devtank-ltd/osm_env01_kicad/kicad_osm_env01/Design/osm_env-01_revC_pinmap_24_10_22.ods

 | RevB Pinmap |  | RevC Pinmap
STM Pin | CH Name | Connected to (KICAD LABEL) | NEW CH Name | NEW Connected to (KICAD LABEL) | Reason for change
PA0 | status_led | status_led | status_led | status_led
PA1 | ADC2 | CT+ | ADC2 | ADC2_OUT (CT1+) | Label update
PA2 | USART2_TX | RS232_RX | USART2_TX | DEBUG_RX | same function, new kicad label
PA3 | USART2_RX | RS232_TX | USART2_RX | DEBUG_TX | same function, new kicad label
PA4 | SPI1_CS | CS | ADC8 | ADC8_OUT (CT3+) | same function, new kicad label
PA5 | SPI1_SCK | STM_SCK | STM_SCK | STM_SCK
PA6 | SPI1_MISO | STM_MISO | STM_MISO | STM_MISO
PA7 | SPI1_MOSI | STM_MOSI | STM_MOSI | STM_MOSI
PA8 | SAI1_SCK_A | MIC_SCK | MIC_SCK | MIC_SCK
PA9 | SAI1_FS_A | MIC_WS | MIC_WS | MIC_WS
PA10 | SAI1_SD_A | MIC_SD | MIC_SD | MIC_SD
PA11 | GPIO8 | PULSE2_OUT | CAN1_RX | CAN_RX | CAN moved to this pin
PA12 | GPIO9 | PULSE1_OUT | CAN1_TX | CAN_TX | CAN moved to this pin
PA13 | SWD_IO | SWD_IO | SWD_IO | SWD_IO
PA14 | SWD_SCK | SWD_SCK | SWD_SCK | SWD_SCK
PA15 | GPIO10 | DE_485 | GPIO10 | DE_485
PB0 | ADC5 | n/a | ADC5 | ADC5_OUT (3V3_CORE_MONITOR) | New adc signal
PB1 | ADC6 | ADC+GPIO | ADC6 | ADC6_OUT (CT2+) | New label
PB2 | GPIO3 | GPIO_8 | GPIO3 | LORA_BOOT | New signal
PB3 | GPIO6 | n/a | GPIO6 | 3V3_CORE_EN | New _signal
PB4 | GPIO12 | n/a | GPIO8 | n/a | Now unused pin
PB5 | GPIO13 | n/a | GPIO9 | PULSE1_OUT | Pulse input moved to this pin
PB6 | USART1_TX | HPM_RX | USART1_TX | HPM_RX
PB7 | USART1_RX | HPM_TX | USART1_RX | HPM_TX
PB8 | I2C1_SCL | I2C_SCL | I2C1_SCL | I2C_SCL
PB9 | I2C1_SDA | I2C_SDA | I2C1_SDA | I2C_SDA
PB10 | LPUART1_RX | STM1_RX | LPUART1_RX | RS485_RX/RS232_RX | Now using lpuart1 for 485/232
PB11 | LPUART1_TX | STM1_TX | LPUART1_TX | RS485_TX/RS232_TX | Now using lpuart1 for 485/233
PB12 | CAN1_RX | CAN_RX | GPIO17 | STM_232_RTS | CAN pin changed to gpio due to limited pin availability | NEW SIGNAL FOR 232
PB13 | CAN1_TX | CAN_TX | GPIO15 | STM_232_CTS | CAN pin changed to gpio due to limited pin availability | NEW SIGNAL FOR 232
PB14 | GPIO14 | CAN_RS | GPIO12 |  | GPIO name updated only
PB15 | GPIO15 | HPM_EN | GPIO13 |  | GPIO name updated only
PC0 | ADC7 | BAT_MON | ADC7 | ADC7_OUT (BAT_MON) | Kicad label renamed from BAT_MON to VBAT_MONITOR
PC1 | SPI1_CS | n/a | ADC1 | ADC1_OUT (BATT_TEMP_MONITOR) | New adc signal
PC2 | ADC3 | 3V3_RAIL_MONITOR | ADC3 | ADC3_OUT (3V3_BOARD_MONITOR) | New KICAD label
PC3 | ADC4 | 5V_RAIL_MONITOR | ADC4 | ADC4_OUT (5VIN_MONITOR) | New KICAD label
PC4 | USART3_TX | LORA_RX | USART3_TX | LORA_RX
PC5 | USART3_RX | LORA_TX | USART3_RX | LORA_TX
PC6 | GPIO1 | GPIO7 | GPIO1 | PULSE2_PULLUP_EN | NEW SIGNAL
PC7 | GPIO11 | n/a | GPIO11 | PULSE1_PULLUP_EN | NEW SIGNAL
PC8 | GPIO2 | n/a | GPIO2 | LORA_RST | New label
PC9 | GPIO4 | n/a | GPIO4 | RS232_ENABLE | New signal
PC10 | UART4_TX | RS485_TX | SPI1_CS | CS | NEW SIGNAL, UNUSED
PC11 | UART4_RX | RS485_RX | GPIO16 | PULSE2_OUT | Pulse PIN MOVED HERE
PC12 | GPIO7 | RE_485 | GPIO7 | RE_485
PC13 | WKUP2 | STM_WAKEUP | WKUP2 | STM_WAKEUP
PC14
PC15
PD2 | GPIO16 | n/a | GPIO14 | RS232_INVALID | GPIO name updated only
NOTE:CRYSTALS NOT FITTED
Key
Minor changes
major change
new signal
