devtank-ltd/osm_env01_kicad/kicad_osm_env01/Design/osm_env-01_revB_pinmap.ods

Sheet: Sheet2
CH Name | STM Pin | Connected to (KICAD LABEL) | Function
ADC1 |  |  | Doesn’t Exist
ADC2 | PA1 | CT1+ | Current Clamp input
ADC3 | PC2 | 3V3_RAIL_MONITOR | 3V3_RAIL_MONITOR
ADC4 | PC3 | 5V_RAIL_MONITOR | 5V_RAIL_MONITOR
ADC5 | PB0 | TP52 | Unused/Mapped to Testpoint
ADC6 | PB1 | ADC+GPIO | NA/Future Expansion | change to CT2+
ADC7 | PC0 | BAT_MON | Battery Monitor
ADC8 | PC13 | TP3 | Unused/Mapped to Testpoint | gpio
GPIO1 | PC6 | GPIO7 | Controlled by Debug chip=2 | gpio
GPIO2 | PC8 | TP17 | Unused/Mapped to Testpoint | gpio
GPIO3 | PB2 | GPIO_8 | Controlled by Debug chip=1 | gpio
GPIO4 | PC9 | TP2 | Unused/Mapped to Testpoint | gpio
GPIO5 |  |  | Doesn’t Exist
GPIO6 | PB3 | TP21 | Unused/Mapped to Testpoint
GPIO7 | PC12 | RE_485 | 485 receiver output enable
GPIO8 | PA11 | PULSE2_OUT | Pulse 2 output
GPIO9 | PA12 | PULSE1_OUT | Pulse 1 output
GPIO10 | PA15 | DE_485 | 485 driver enable
GPIO11 | PC7 | TP16 | Unused/Mapped to Testpoint
GPIO12 | PB4 | TP15 | Unused/Mapped to Testpoint
GPIO13 | PB5 | TP10 | Unused/Mapped to Testpoint
GPIO14 | PB14 | CAN_RS | Not Fitted onboard
GPIO15 | PB15 | HPM_EN | Particulate sensor enable pin
GPIO16 | PD2 | TP53 | Unused/Mapped to Testpoint
USART1_RX | PB7 | HPM_TX | Particulate Sensor Comms
USART1_TX | PB6 | HPM_RX | Particulate Sensor Comms
USART2_RX | PA3 | RS232_TX | USB Debug
USART2_TX | PA2 | RS232_RX | USB Debug
USART3_RX | PC5 | LORA_TX | LORA Comms
USART3_TX | PC4 | LORA_RX | LORA Comms
UART4_RX | PC11 | RS485_RX | 485 Comms
UART4_TX | PC10 | RS485_TX | 485 Comms
LPUART1_RX | PB10 | STM1_RX | NA/Future Expansion
LPUART1_TX | PB11 | STM1_TX | NA/Future Expansion
CAN1_RX | PB12 | CAN_RX | Not Fitted onboard
CAN1_TX | PB13 | CAN_TX | Not Fitted onboard
I2C1_SDA | PB9 | I2C_SDA | Light/Temperature sensor
I2C1_SCL | PB8 | I2C_SCL | Light/Temperature sensor
SPI1_MOSI | PA7 | STM_MOSI | NA/Future Expansion
SPI1_MISO | PA6 | STM_MISO | NA/Future Expansion
SPI1_SCK | PA5 | STM_SCK | NA/Future Expansion
SPI1_CS | PA4 | CS | NA/Future Expansion | change to CT3+
SAI1_SCK_A | PA8 | MIC_SCK | Microphone Module Comms
SAI1_SD_A | PA10 | MIC_SD | Microphone Module Comms
SAI1_FS_A | PA9 | MIC_WS | Microphone Module Comms
WKUP2 | PC13 | STM_WAKEUP | Controlled by Debug chip=0
status_led | PA0 | status_led | STM status led
SWD_IO | PA13 | SWD_IO | SWD Programming Pin
SWD_SCK | PA14 | SWD_SCK | SWD Programming Pin
NOTE:32khz crystal not fitted
Note: U7 485 transciever has been replaced for ADM3485ARZ-REEL7
May need to move DE_485 to another pin as internal pull up activated on PA15 after reset

Sheet: Sheet1
CH Name | STM Pin | Connected to (KICAD LABEL) | Function
ADC1 |  |  | Doesn’t Exist
ADC2 | PA1 | CT+ | Current Clamp input
ADC3 | PC2 | 3V3_RAIL_MONITOR | 3V3_RAIL_MONITOR
ADC4 | PC3 | 5V_RAIL_MONITOR | 5V_RAIL_MONITOR
ADC5 | PB0 | TP52 | Unused/Mapped to Testpoint
ADC6 | PB1 | ADC+GPIO | NA/Future Expansion
ADC7 | PC0 | BAT_MON | Battery Monitor
ADC8 | PC13 | TP3 | Unused/Mapped to Testpoint | gpio
GPIO1 | PC6 | GPIO7 | Controlled by Debug chip=2 | gpio
GPIO2 | PC8 | TP17 | Unused/Mapped to Testpoint | gpio
GPIO3 | PB2 | GPIO_8 | Controlled by Debug chip=1 | gpio
GPIO4 | PC9 | TP2 | Unused/Mapped to Testpoint | gpio
GPIO5 |  |  | Doesn’t Exist
GPIO6 | PB3 | TP21 | Unused/Mapped to Testpoint
GPIO7 | PC12 | RE_485 | 485 receiver output enable
GPIO8 | PA11 | PULSE2_OUT | Pulse 2 output
GPIO9 | PA12 | PULSE1_OUT | Pulse 1 output
GPIO10 | PA15 | DE_485 | 485 driver enable
GPIO11 | PC7 | TP16 | Unused/Mapped to Testpoint
GPIO12 | PB4 | TP15 | Unused/Mapped to Testpoint
GPIO13 | PB5 | TP10 | Unused/Mapped to Testpoint
GPIO14 | PB14 | CAN_RS | Not Fitted onboard
GPIO15 | PB15 | HPM_EN | Particulate sensor enable pin
GPIO16 | PD2 | TP53 | Unused/Mapped to Testpoint
USART1_RX | PB7 | HPM_TX | Particulate Sensor Comms
USART1_TX | PB6 | HPM_RX | Particulate Sensor Comms
USART2_RX | PA3 | RS232_TX | USB Debug
USART2_TX | PA2 | RS232_RX | USB Debug
USART3_RX | PC5 | LORA_TX | LORA Comms
USART3_TX | PC4 | LORA_RX | LORA Comms
UART4_RX | PC11 | RS485_RX | 485 Comms
UART4_TX | PC10 | RS485_TX | 485 Comms
LPUART1_RX | PB10 | STM1_RX | NA/Future Expansion
LPUART1_TX | PB11 | STM1_TX | NA/Future Expansion
CAN1_RX | PB12 | CAN_RX | Not Fitted onboard
CAN1_TX | PB13 | CAN_TX | Not Fitted onboard
I2C1_SDA | PB9 | I2C_SDA | Light/Temperature sensor
I2C1_SCL | PB8 | I2C_SCL | Light/Temperature sensor
SPI1_MOSI | PA7 | STM_MOSI | NA/Future Expansion
SPI1_MISO | PA6 | STM_MISO | NA/Future Expansion
SPI1_SCK | PA5 | STM_SCK | NA/Future Expansion
SPI1_CS | PA4 | CS | NA/Future Expansion
SAI1_SCK_A | PA8 | MIC_SCK | Microphone Module Comms
SAI1_SD_A | PA10 | MIC_SD | Microphone Module Comms
SAI1_FS_A | PA9 | MIC_WS | Microphone Module Comms
WKUP2 | PC13 | STM_WAKEUP | Controlled by Debug chip=0
status_led | PA0 | status_led | STM status led
SWD_IO | PA13 | SWD_IO | SWD Programming Pin
SWD_SCK | PA14 | SWD_SCK | SWD Programming Pin
NOTE:32khz crystal not fitted
Note: U7 485 transciever has been replaced for ADM3485ARZ-REEL7
May need to move DE_485 to another pin as internal pull up activated on PA15 after reset

Sheet: Sheet3
 | 451 | 433
can rx | pb12 | pa11
can rx | pa11 | pd0
can rx | pb5 | pb8
can rx | pb8
can tx | pb13 | pa12
can tx | pa12 | pd1
can tx | pb6 | pb9
can tx | pb9
lpuart rx | pc0 | pc0
lpuart rx | pa3 | pa3
lpuart rx | pb10 | pb10
lpuart tx | pc1 | pc1
lpuart tx | pa2 | pa2
lpuart tx | pb11 | pb11
