devtank-ltd/osm_env01_kicad/kicad_osm_env01/3D/2169890001- USB_C_Connector.stp

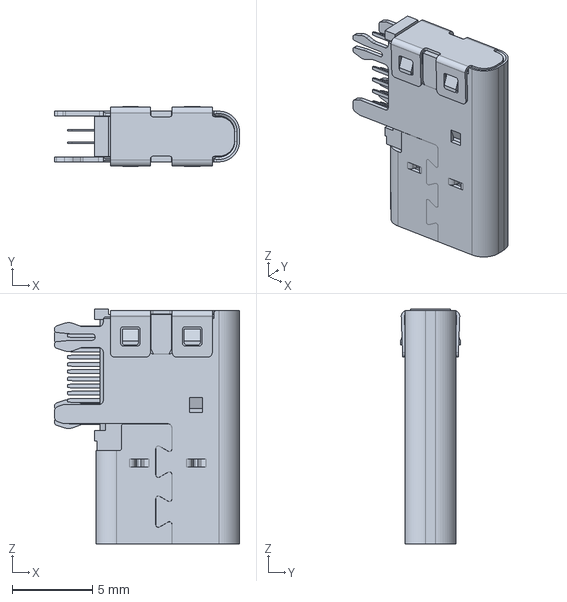
[picture p1: CAD file, 2023-09-20]
kicad_osm_env01/3D/2169890001- USB_C_Connector.stp
11.5 x 3.76 x 14.7 mm
