devtank-ltd/osm_env01_kicad/kicad_osm_env01/Design/OSM_env01_RevD.pdf

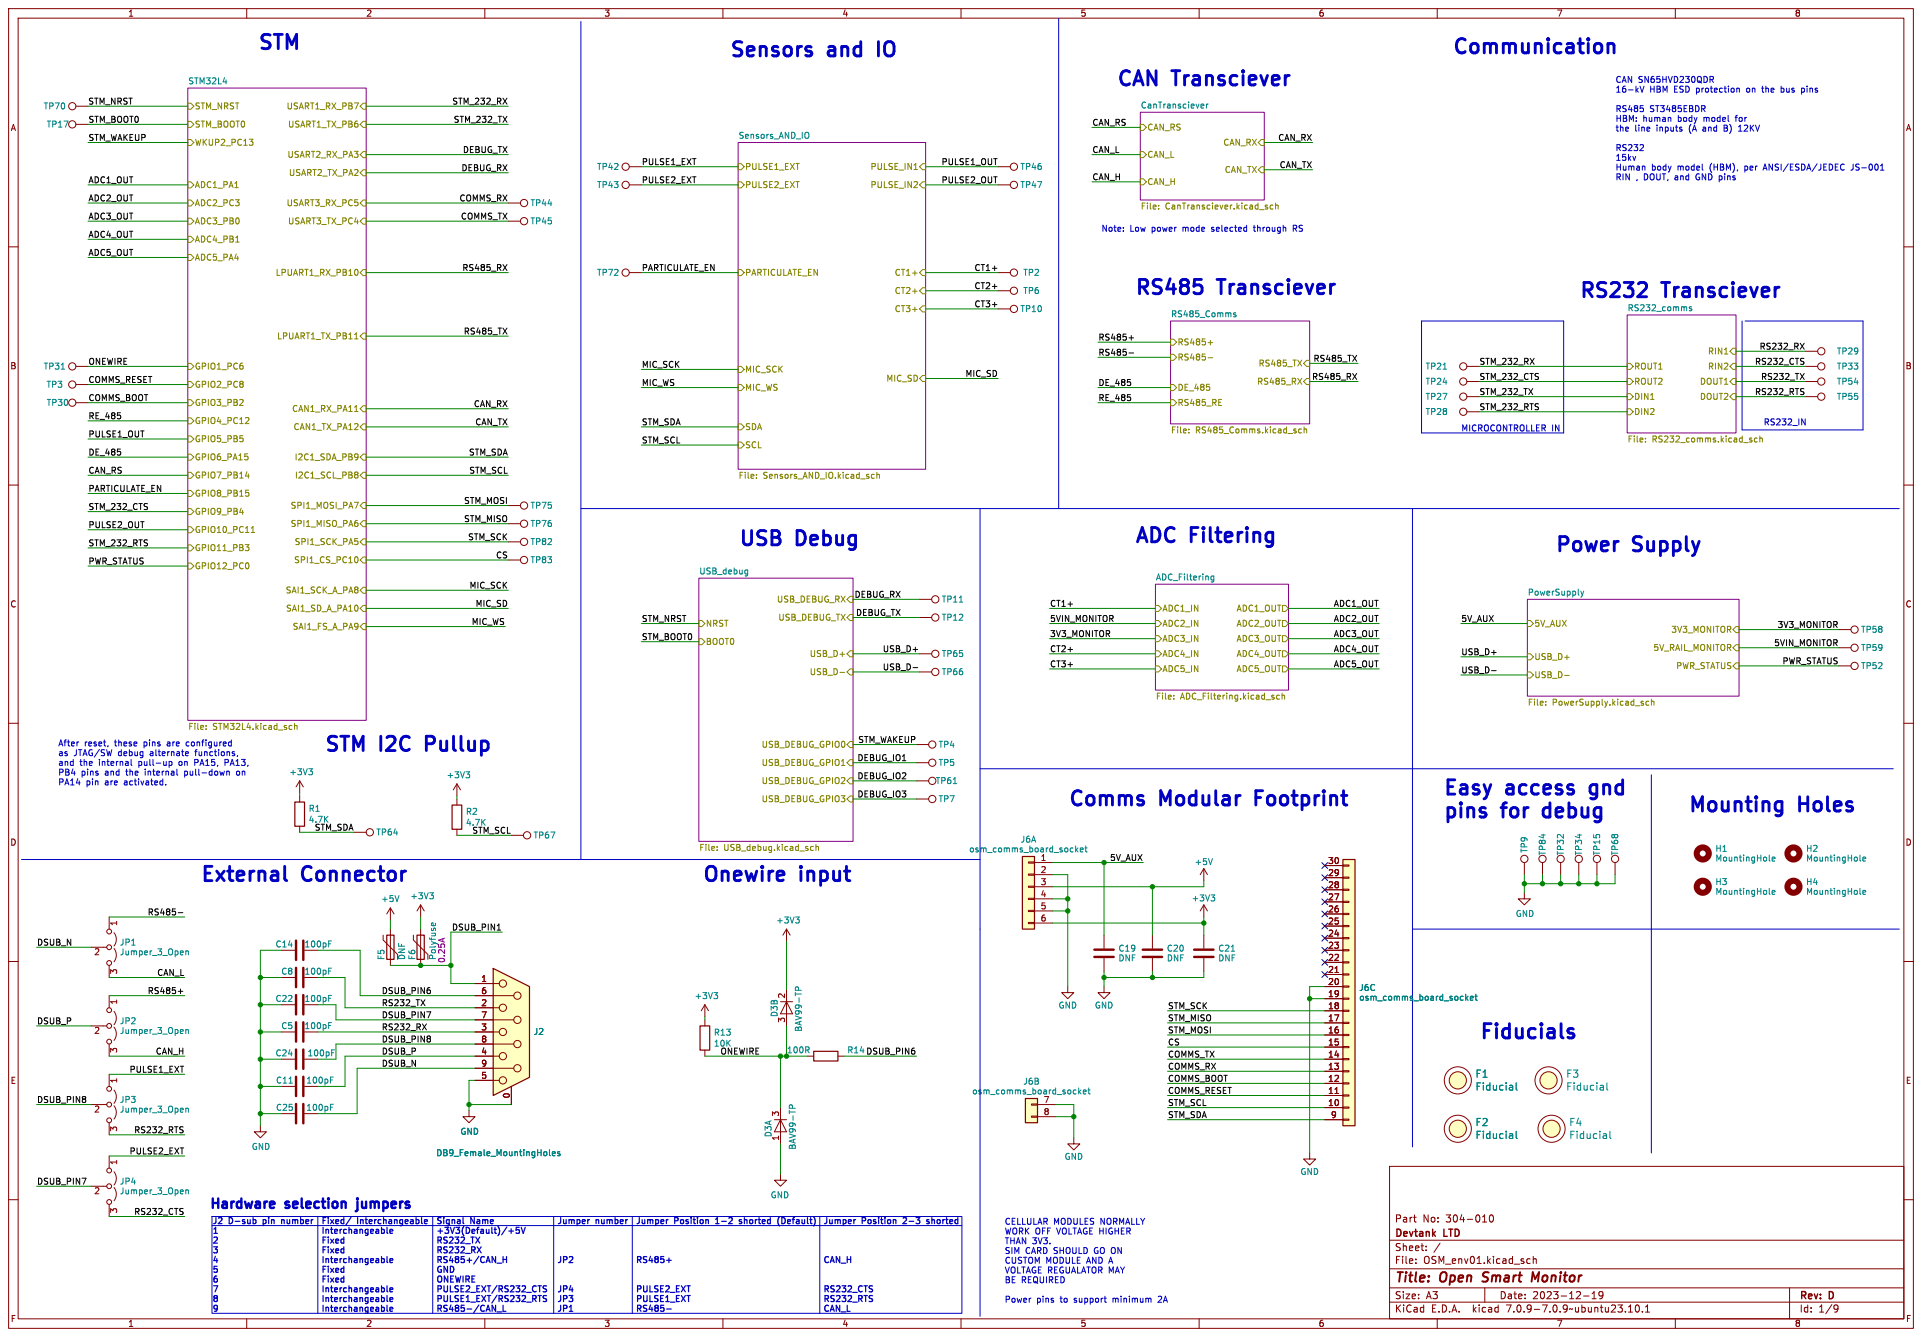
[picture p2: page 1]

HBM: human body model for
the line inputs (A and B) 12KV RS232

After reset, these pins are configured

pins for debug Comms Modular Footprint

Signal Name +3V3(Default)/+5V RS232_TX RS232_RX RS485+/CAN_H GND ONEWIRE

CELLULAR MODULES NORMALLY WORK OFF VOLTAGE HIGHER

THAN 3V3. SIM CARD SHOULD GO ON

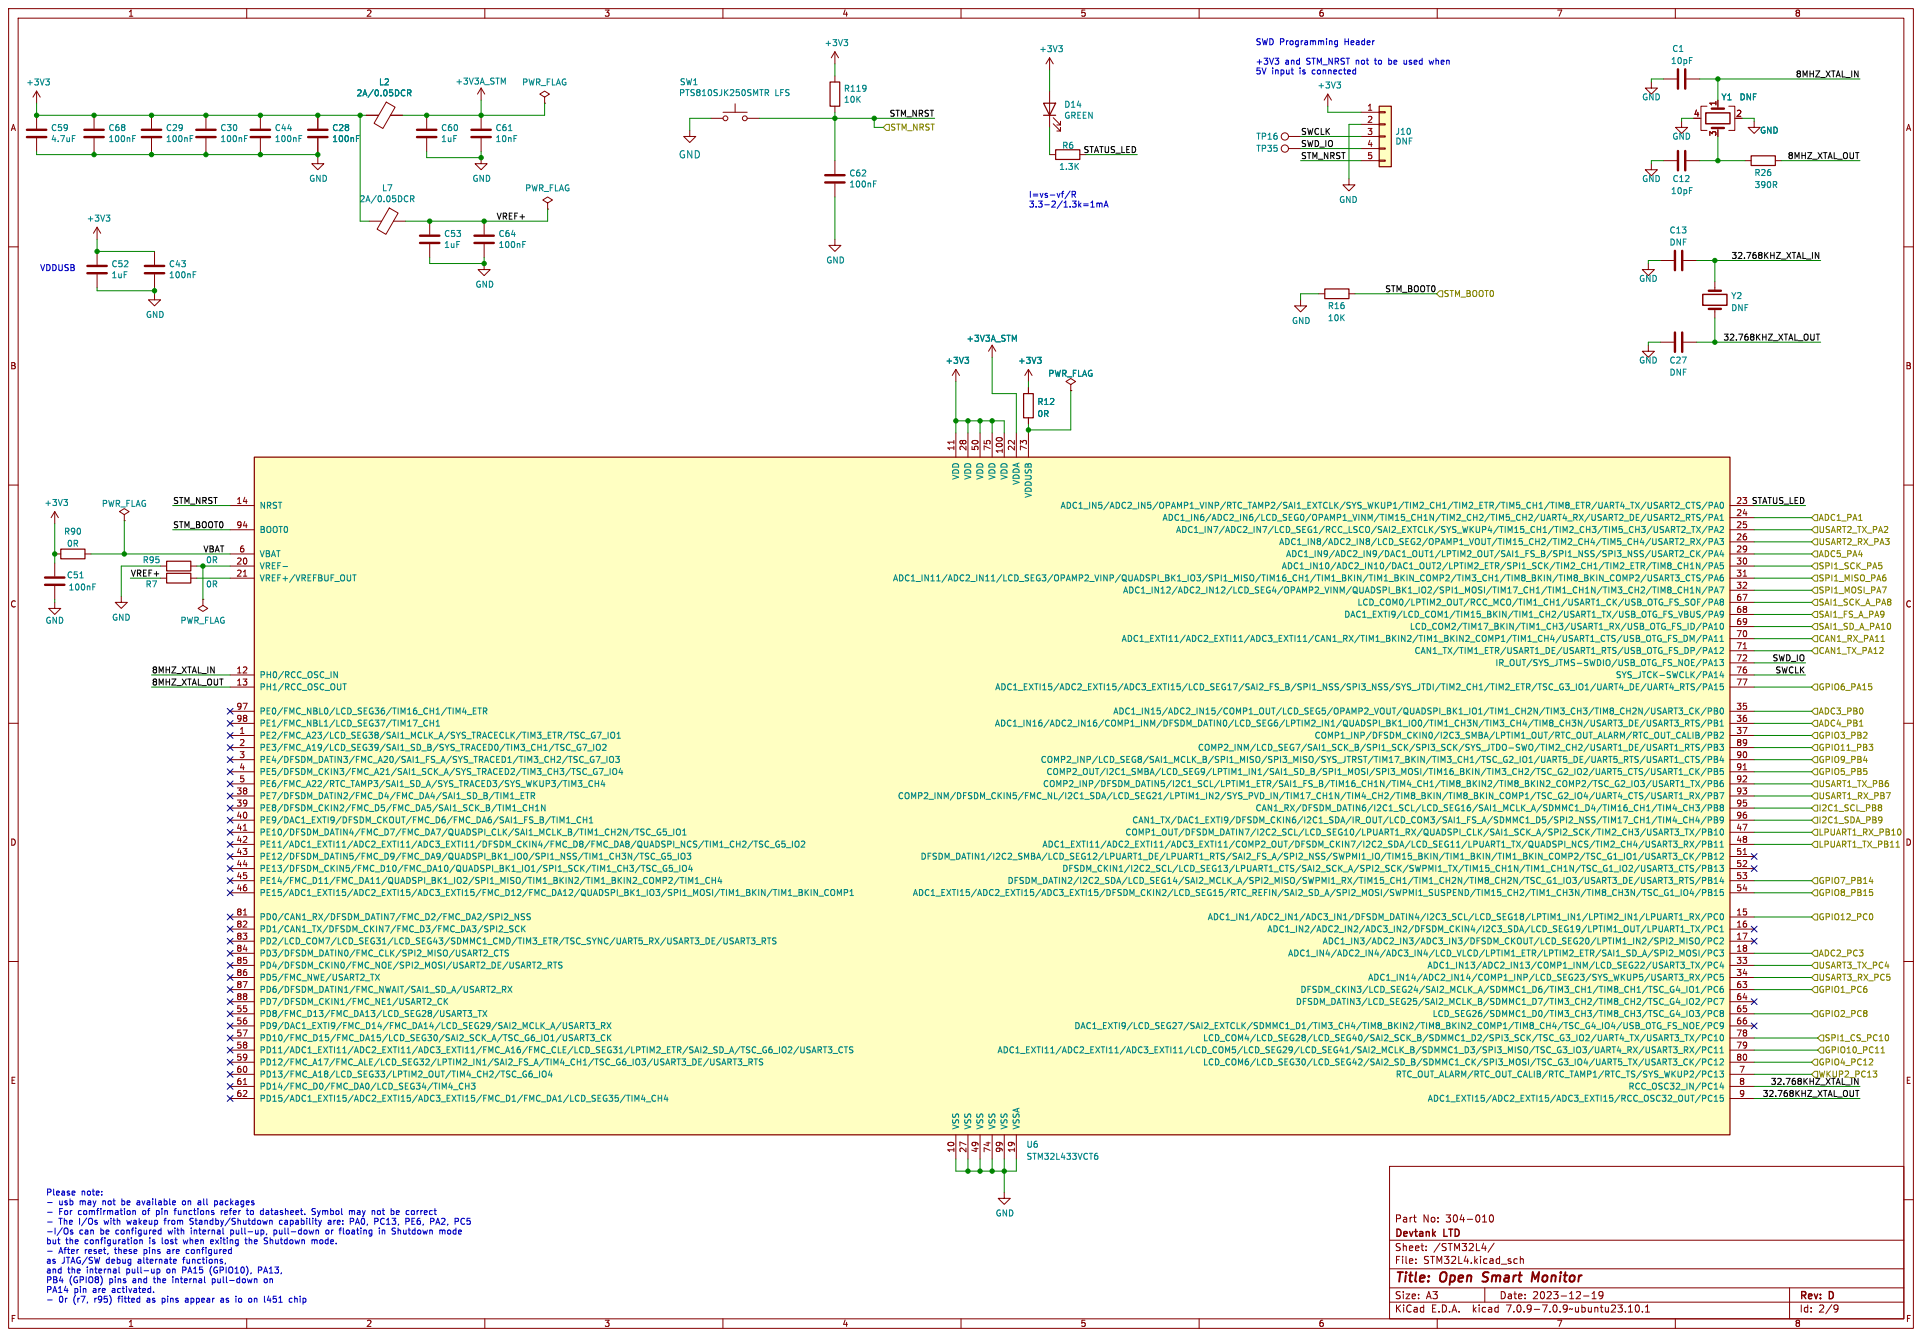
[picture p3: page 2]

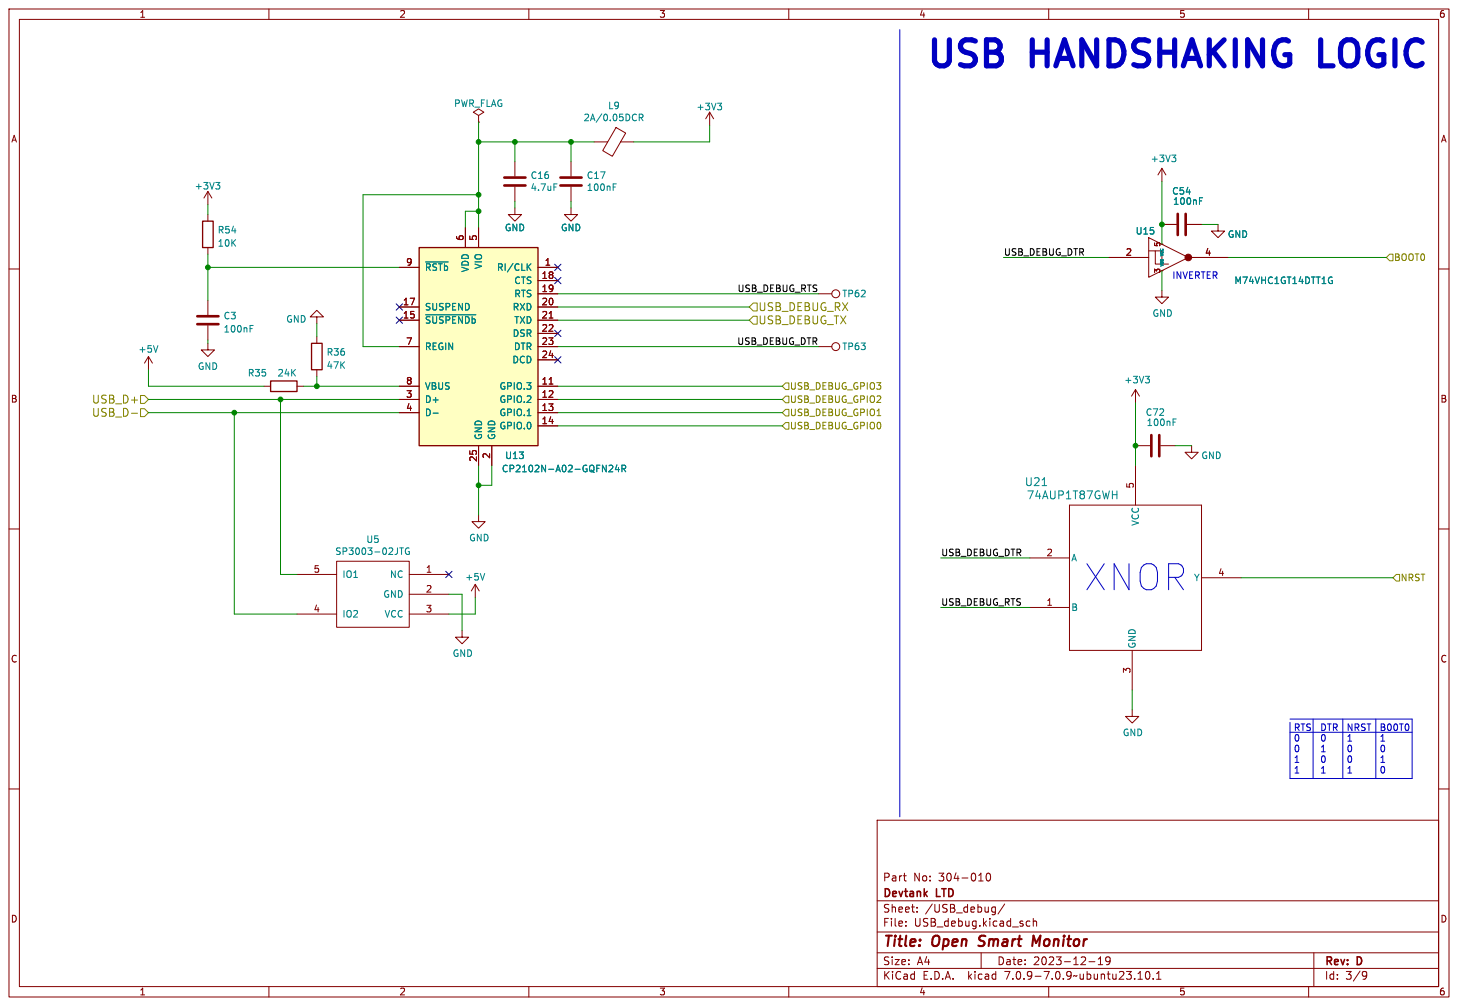
[picture p4: page 3]

6 REGIN 7 VBUS 8 ~{RSTb} 9 U13 CP2102N-A02-GQFN24R GND GND

6 REGIN 7 VBUS 8 ~{RSTb} 9 GND GND

2 RXD 20 TXD 21 DSR 22 DTR 23 DCD 24 GND 25 D+ 3 D- 4 VIO

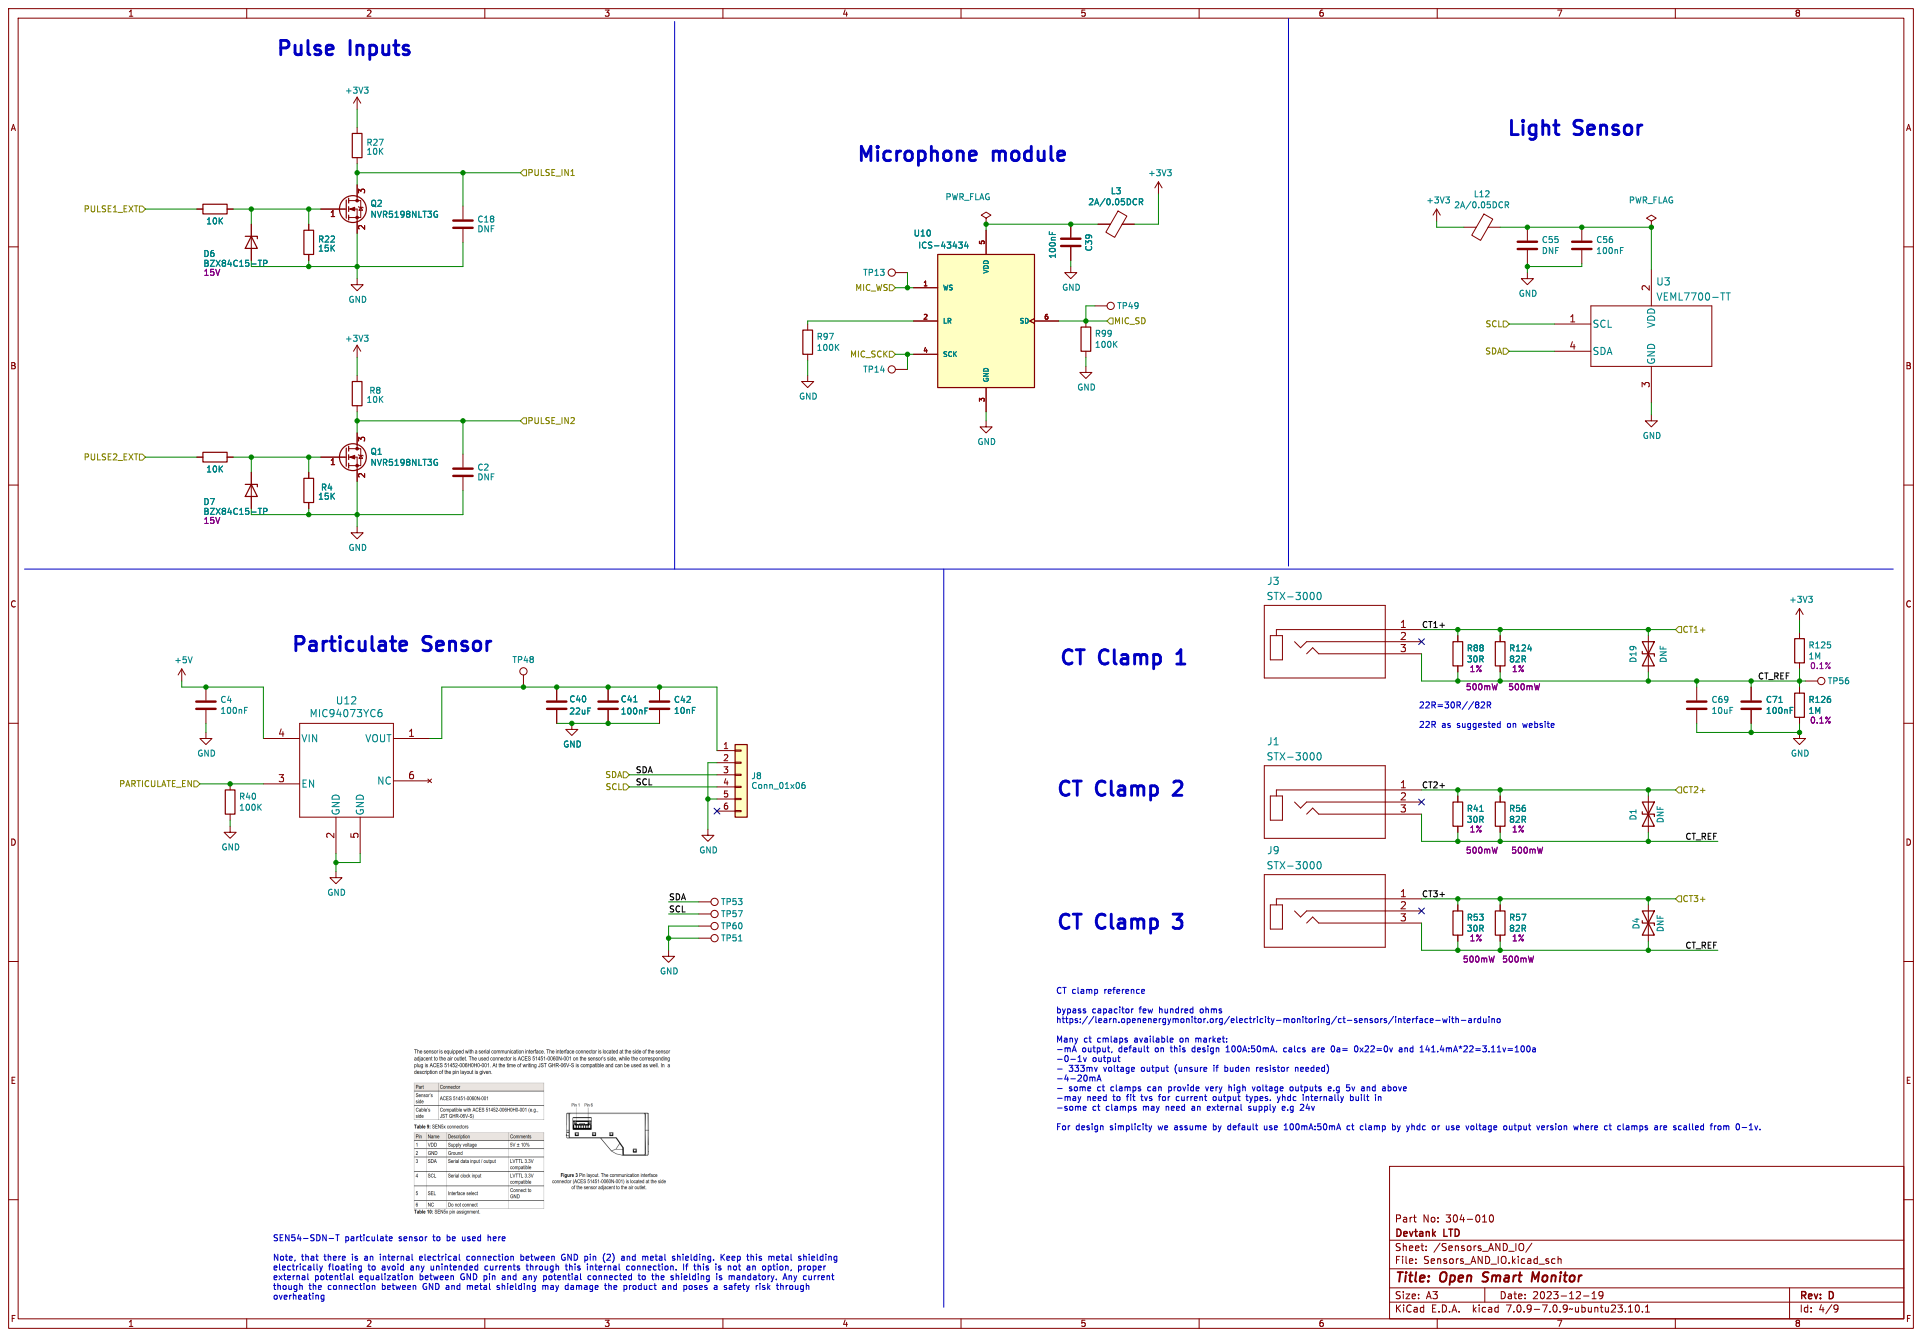
[picture p5: page 4]

- some ct clamps can provide very high voltage outputs e.g 5v and above

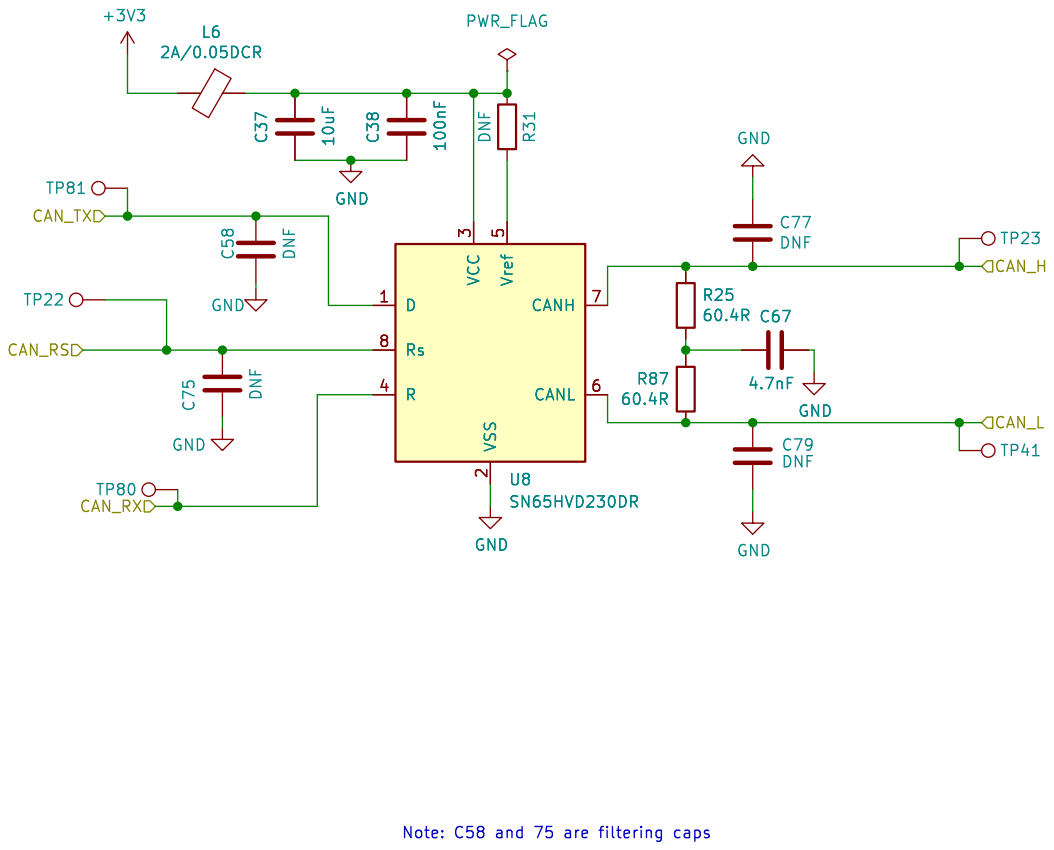
[picture p6: page 5]

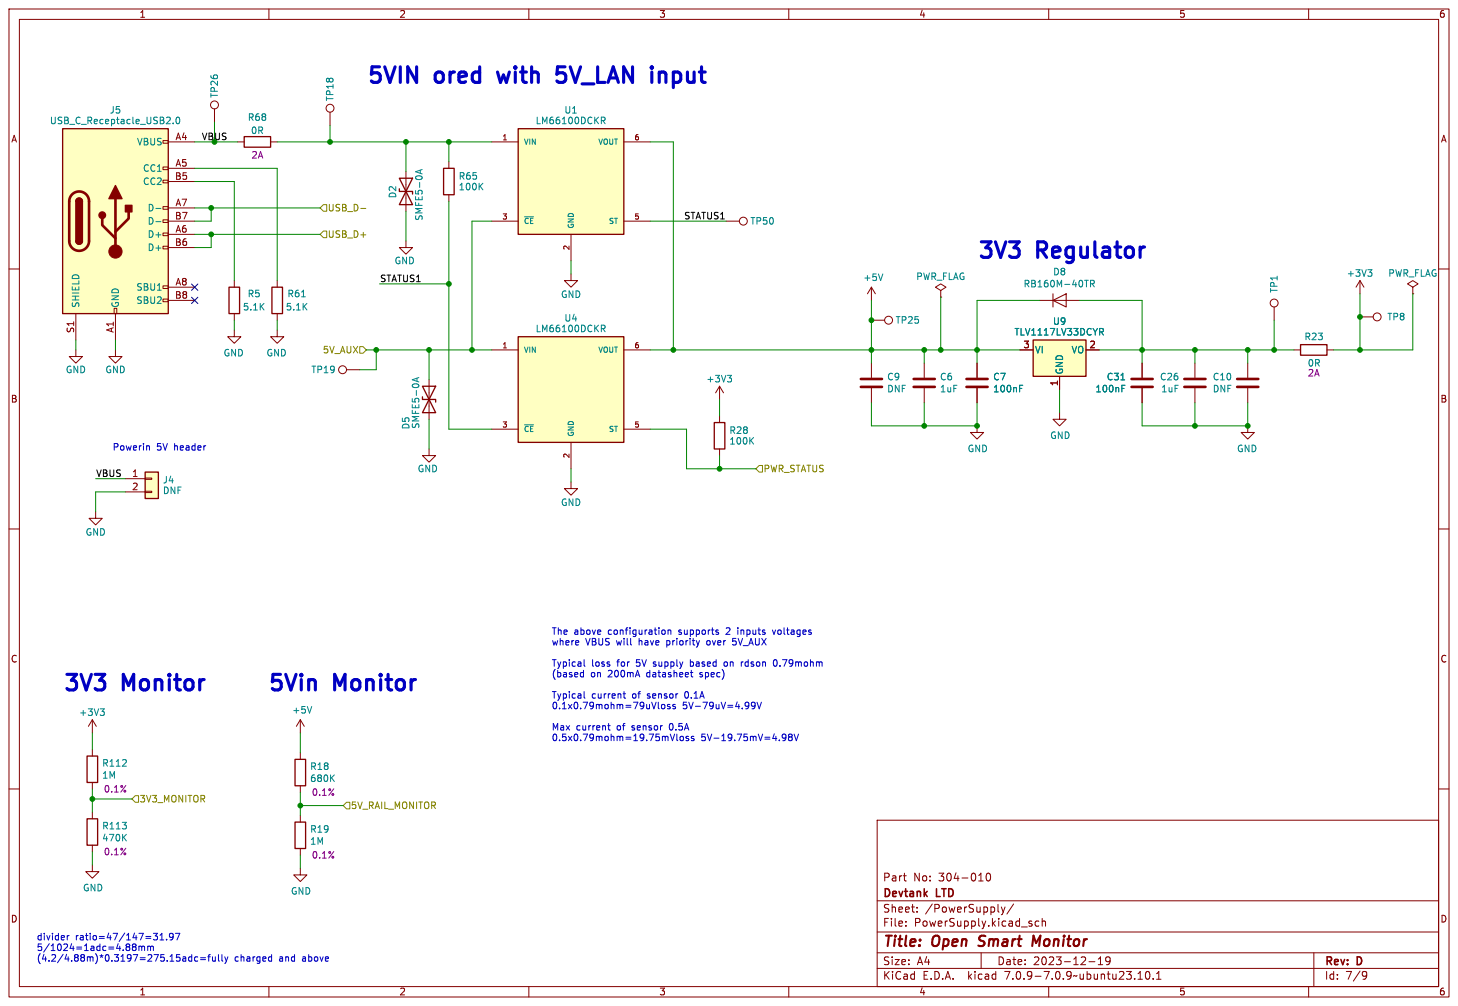
[picture p7: page 6]

Powerin 5V header divider ratio=47/147=31.97

Typical loss for 5V supply based on rdson 0.79mohm

Typical current of sensor 0.1A

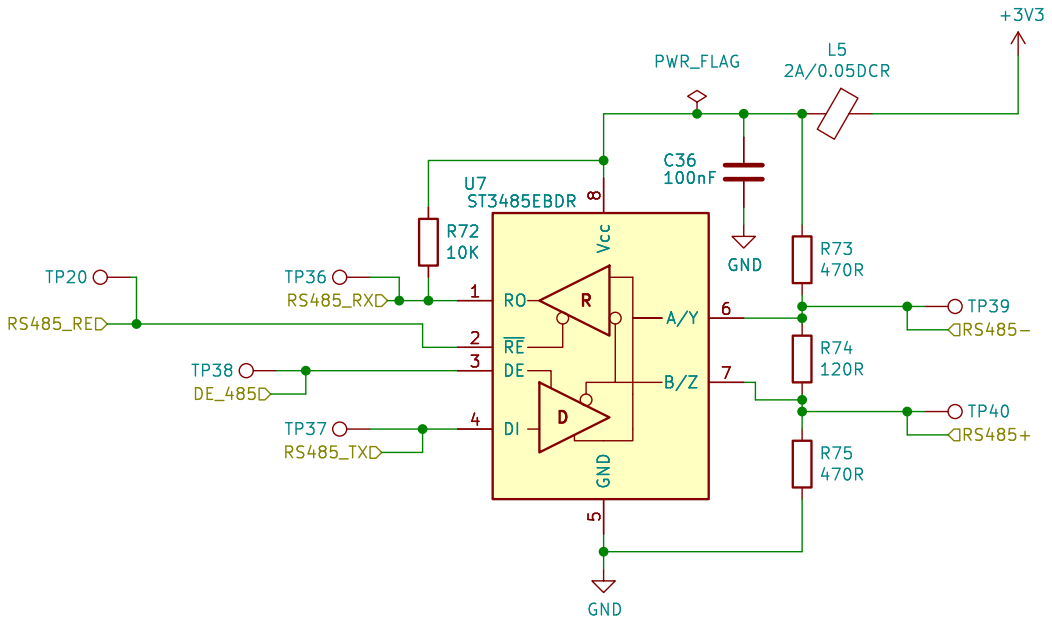
[picture p8: page 7]

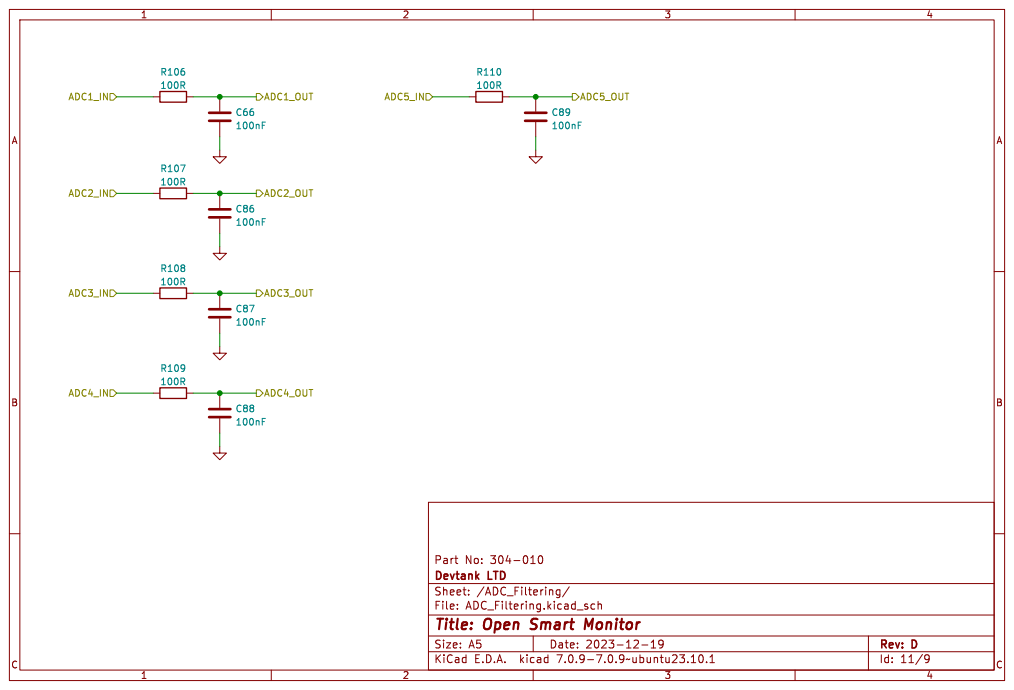
[picture p9: page 8]

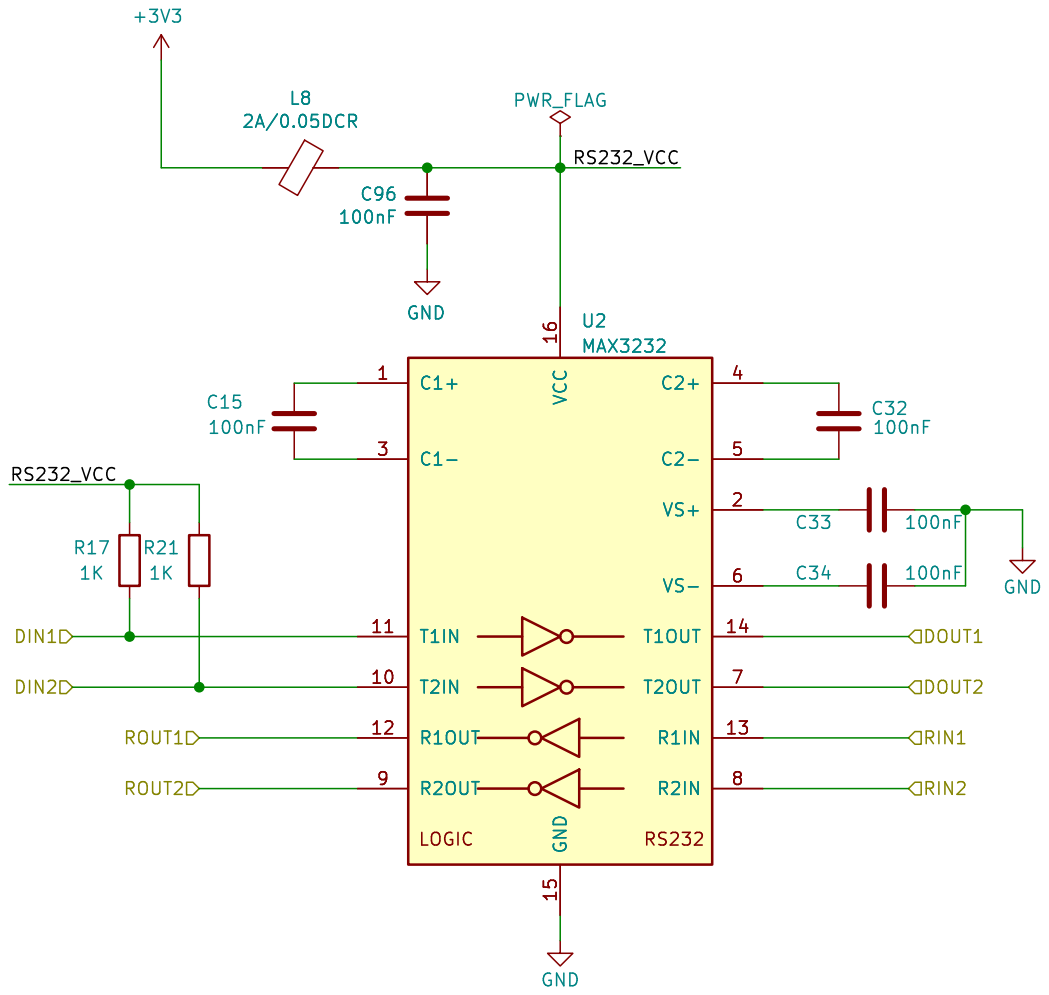
[picture p10: page 9]
