devtank-ltd/osm_env01_kicad/(commit log)

2021-03-19 setup main public project with clean history
    [DigitalIO.sch, Digital_IO.sch, OSM_env01.kicad_pcb, OSM_env01.sch, Sound.sch, USB_debug.sch]
2021-03-19 updated CERN license
    [OSM_env01.kicad_pcb]
2021-03-19 added BOM
    [OSM_ENV01_BOM_RevA.ods]
2021-03-23 audio circuit updated
    [OSM_env01.kicad_pcb, OSM_env01.sch, Sound.sch]
2021-03-26 pushed latest schematics got started with micro into schematic
    [Digital_IO.sch, LORA.sch, OSM_env01.sch, PowerSupply.sch, RS485_Comms.sch, Sensors_AND_IO.sch, Sound.sch, USB_debug.sch]
2021-03-30 stm32 added to kicad
    [Digital_IO.sch, LORA.sch, OSM_env01.kicad_pcb, OSM_env01.sch, PowerSupply.sch, RS485_Comms.sch, STM32L4.sch, Sensors_AND_IO.sch]
2021-03-30 kicad review sch initial
    [LORA.sch, OSM_env01.sch, PowerSupply.sch, RS485_Comms.sch, STM32L4.sch, Sensors_AND_IO.sch, Sound.sch]
2021-03-31 updated schematics
    [CanTransciever.sch, Digital_IO.sch, LORA.sch, OSM_env01.sch, PowerSupply.sch, PrecisionVRef.sch, RS485_Comms.sch, STM32L4.sch]
2021-04-06 schematics awaiting review
    [CanTransciever.sch, Digital_IO.sch, LORA.sch, OSM_env01.sch, PowerSupply.sch, PrecisionVRef.sch, RS485_Comms.sch, STM32L4.sch]
2021-04-08 started layout
    [CanTransciever.sch, Digital_IO.sch, LORA.sch, OSM_env01.kicad_pcb, OSM_env01.sch, PowerSupply.sch, PrecisionVRef.sch, RS485_Comms.sch]
2021-04-09 Throwdown of parts
    [CanTransciever.sch, LORA.sch, OSM_env01.kicad_pcb, OSM_env01.sch, PowerSupply.sch, STM32L4.sch, Sensors_AND_IO.sch, Sound.sch]
2021-08-26 updated 3d step file
    [CanTransciever.sch, LORA.sch, OSM_env01.csv, OSM_env01.kicad_pcb, OSM_env01.sch, STM32L4.sch, Sensors_AND_IO.sch, Sound.sch]
2021-09-07 added stm to schematic
    [OSM_env01.kicad_pcb, OSM_env01.sch, STM32L4.sch, Sound.sch]
2021-09-12 pushed common folder with schematics
2021-09-15 rough layout with throwdown of parts
    [CanTransciever.sch, Digital_IO.sch, LORA.sch, OSM_env01.kicad_pcb, OSM_env01.sch, PowerSupply.sch, PrecisionVRef.sch, RS485_Comms.sch]
2021-09-21 added caps to particulate sensor
    [Sensors_AND_IO.sch]
2021-09-23 rough throwdown of all parts
    [CanTransciever.sch, Digital_IO.sch, LORA.sch, OSM_env01.csv, OSM_env01.kicad_pcb, OSM_env01.sch, OSM_env01_RevB_BOM.ods, PowerSupply.sch]
2021-09-27 schematics and layout submitted for review
    [OSM_env01.kicad_pcb, OSM_env01.sch, PowerSupply.sch, STM32L4.sch, Sensors_AND_IO.sch]
2021-09-29 osm env-01 revB finished
    [CanTransciever.sch, Digital_IO.sch, LORA.sch, OSM_env01.kicad_pcb, OSM_env01.sch, PowerSupply.sch, RS485_Comms.sch, STM32L4.sch]
2021-09-30 Bom and gerbers added
    [LORA.sch, OSM_ENV01_BOM_REVB.ods, OSM_env01.csv, OSM_env01.kicad_pcb, OSM_env01_RevB_BOM.ods, PowerSupply.sch, Sensors_AND_IO.sch]
2021-09-30 added part numbers to bom
    [OSM_ENV01_BOM_REVB.ods]
2021-10-20 Remove absolute pathes, replace with relative paths.
    [OSM_env01.kicad_pcb]
2022-03-31 updated folder
    [Digital_IO.sch, OSM_ENV01_BOM_REVB.ods, OSM_env01.csv, OSM_env01.kicad_pcb, OSM_env01.sch, STM32L4.sch, Sensors_AND_IO.sch]
2022-03-31 Getting started in kicad V6 and updated changed document
    [CanTransciever.kicad_sch, Digital_IO.kicad_sch, LORA.kicad_sch, OSM_ENV01_BOM_REVB.ods, OSM_ENV01_BOM_REVB_2.ods, OSM_env01.kicad_sch, PowerSupply.kicad_sch, RS485_Comms.kicad_sch]
2022-04-03 added stml433 to schematic and carried out some mods
    [CanTransciever.kicad_sch, Digital_IO.kicad_sch, InputConditioning.kicad_sch, LORA.kicad_sch, OSM_env01.kicad_sch, PowerSupply.kicad_sch, RS485_Comms.kicad_sch, STM32L4.kicad_sch]
2022-05-19 updated mod list
    [CanTransciever.kicad_sch, Digital_IO.kicad_sch, InputConditioning.kicad_sch, OSM_env01.kicad_pcb, OSM_env01.kicad_sch, PowerSupply.kicad_sch, STM32L4.kicad_sch, Sensors_AND_IO.kicad_sch]
2022-07-02 added new battery charge ic u2
    [CanTransciever.kicad_sch, Digital_IO.kicad_sch, InputConditioning.kicad_sch, LORA.kicad_sch, OSM_env01.kicad_sch, PowerSupply.kicad_sch, RS485_Comms.kicad_sch, STM32L4.kicad_sch]
2022-08-09 updated schematics and added rs232
    [ADC_Filtering.kicad_sch, Digital_IO.kicad_sch, InputConditioning.kicad_sch, LORA.kicad_sch, OSM_env01.kicad_sch, PowerSupply.kicad_sch, RS232_comms.kicad_sch, STM32L4.kicad_sch]
2022-08-20 Schematics waiting review
    [ADC_Filtering.kicad_sch, CanTransciever.kicad_sch, Digital_IO.kicad_sch, LORA.kicad_sch, OSM_ENV01_BOM_REVC.ods, OSM_env01.kicad_sch, OSM_env01_2.csv, PowerSupply.kicad_sch]
2022-08-23 before fixing devtank symbol issues
    [Digital_IO.kicad_sch, LORA.kicad_sch, OSM_env01.kicad_sch, PowerSupply.kicad_sch, RS232_comms.kicad_sch, STM32L4.kicad_sch, Sensors_AND_IO.kicad_sch, USB_debug.kicad_sch]
2022-08-27 started layout with throwdown
    [ADC_Filtering.kicad_sch, CanTransciever.kicad_sch, Digital_IO.kicad_sch, LORA.kicad_sch, OSM_ENV01_BOM_REVC.ods, OSM_env01.kicad_pcb, OSM_env01.kicad_sch, PowerSupply.kicad_sch]
2022-08-31 Complete half pcb layout with routed signals
    [Digital_IO.kicad_sch, LORA.kicad_sch, OSM_env01.kicad_pcb, OSM_env01.kicad_sch, PowerSupply.kicad_sch, Sensors_AND_IO.kicad_sch]
2022-09-01 majority of signals routed on layout
    [ADC_Filtering.kicad_sch, CanTransciever.kicad_sch, Digital_IO.kicad_sch, LORA.kicad_sch, OSM_env01.kicad_sch, PowerSupply.kicad_sch, RS232_comms.kicad_sch, RS485_Comms.kicad_sch]
2022-09-07 updated layout
    [CanTransciever.kicad_sch, Digital_IO.kicad_sch, OSM_env01.kicad_sch, PowerSupply.kicad_sch, STM32L4.kicad_sch, Sensors_AND_IO.kicad_sch, USB_debug.kicad_sch]
2022-09-07 Layout finished
    [Digital_IO.kicad_sch, OSM_env01.kicad_sch, PowerSupply.kicad_sch, STM32L4.kicad_sch, USB_debug.kicad_sch]
2022-09-07 updated schematic pdf
2022-09-16 osm rev c schematics and layout finished
    [ADC_Filtering.kicad_sch, CanTransciever.kicad_sch, Digital_IO.kicad_sch, LORA.kicad_sch, OSM_ENV01_BOM_REVC_V1.ods, OSM_env01.kicad_sch, PowerSupply.kicad_sch, RS232_comms.kicad_sch]
2022-09-17 minor update of year to cern logo and added gerbers
2022-09-26 Updated layout and gerbers with mounting holes
    [ADC_Filtering.kicad_sch, CanTransciever.kicad_sch, Digital_IO.kicad_sch, LORA.kicad_sch, OSM_env01.kicad_sch, PowerSupply.kicad_sch, RS232_comms.kicad_sch, RS485_Comms.kicad_sch]
2022-10-24 Updated pinmap document for osm rev c
    [OSM_ENV01_BOM_REVC_V1.ods, osm_env-01_revC_pinmap_24_10_22.ods]
2022-12-14 pushed common folder on env 01 kicad
2023-02-02 added new rev c v2 bom and updated changes document with rev d mods
    [OSM_ENV01_BOM_REVC_V1.ods, OSM_ENV01_BOM_REVC_V2.ods]
2023-02-02 updated pin labels for RS232 IC and d-type connector
    [Digital_IO.kicad_sch, OSM_env01.kicad_sch]
2023-02-03 updated d-type pin mapping on schematic sheet for correct rs485 labels and updated changes document with mods
    [Digital_IO.kicad_sch, OSM_env01.kicad_sch]
2023-02-03 V3 bom added includes 1M 680k and 2.4k resistor changes
    [OSM_ENV01_BOM_REVC_V3.ods]
2023-02-23 bom v3 up issued to v3.1 as some errors previously in v3
    [OSM_ENV01_BOM_REVC_V3.1.ods, OSM_ENV01_BOM_REVC_V3.ods]
2023-05-16 updated changes document with revc mods
    [Digital_IO.kicad_sch, OSM_env01.kicad_sch]
2023-05-22 updated changes document with xnor power mod and updated schematics with mods so far for osm rev c
    [Digital_IO.kicad_sch, LORA.kicad_sch, OSM_env01.kicad_sch, PowerSupply.kicad_sch, RS232_comms.kicad_sch, Sensors_AND_IO.kicad_sch, USB_debug.kicad_sch]
2023-06-06 added mods for battery switch to text file and updated schematic with mods
    [Digital_IO.kicad_sch, OSM_env01.kicad_sch, PowerSupply.kicad_sch]
2023-06-09 updated changes document with power supply mod for 5V to particle sensor
2023-06-12 exported schematics with mods so far
2023-06-16 added version numbers to changes text file
    [Digital_IO.kicad_sch, OSM_env01.kicad_sch, Sensors_AND_IO.kicad_sch]
2023-09-13 Updated schematics with RevD V1.4 mods from CHANGES text file
    [ADC_Filtering.kicad_sch, CanTransciever.kicad_sch, Digital_IO.kicad_sch, LORA.kicad_sch, OSM_env01.kicad_sch, PowerSupply.kicad_sch, RS232_comms.kicad_sch, RS485_Comms.kicad_sch]
2023-09-19 added usb c connector to schematics
    [Digital_IO.kicad_sch, OSM_env01.kicad_sch, PowerSupply.kicad_sch, USB_debug.kicad_sch]
2023-09-20 removed battery circuit and add usb c to schematics
    [2169890001- USB_C_Connector.stp, Digital_IO.kicad_sch, OSM_env01.kicad_sch, PowerSupply.kicad_sch, STM32L4.kicad_sch, Sensors_AND_IO.kicad_sch, USB_debug.kicad_sch]
2023-09-21 started designing modular io board footprint
    [Digital_IO.kicad_sch, OSM_env01.kicad_sch, PowerSupply.kicad_sch]
2023-09-27 removed io module and 5V regulator
    [ADC_Filtering.kicad_sch, CanTransciever.kicad_sch, Digital_IO.kicad_sch, OSM_env01.kicad_sch, PowerSupply.kicad_sch, RS232_comms.kicad_sch, RS485_Comms.kicad_sch, STM32L4.kicad_sch]
2023-09-27 updated schematics with 5V ored circuit and new 3v3 regulator
    [ADC_Filtering.kicad_sch, Digital_IO.kicad_sch, OSM_env01.kicad_sch, PowerSupply.kicad_sch, STM32L4.kicad_sch, USB_debug.kicad_sch]
2023-09-28 positioned comms board and sen54 particle sensor on layout
    [Digital_IO.kicad_sch, OSM_env01.kicad_sch, Sensors_AND_IO.kicad_sch]
2023-09-29 locked in main connectors for connector end on layout
    [Digital_IO.kicad_sch, OSM_env01.kicad_pcb, OSM_env01.kicad_sch, PowerSupply.kicad_sch]
2023-10-02 assigned all footprints
    [ADC_Filtering.kicad_sch, CanTransciever.kicad_sch, Digital_IO.kicad_sch, OSM_env01.kicad_pcb, OSM_env01.kicad_sch, PowerSupply.kicad_sch, RS232_comms.kicad_sch, RS485_Comms.kicad_sch]
2023-10-06 started layout throwdown
    [Digital_IO.kicad_sch, OSM_env01.kicad_pcb, OSM_env01.kicad_sch, PowerSupply.kicad_sch, Sensors_AND_IO.kicad_sch]
2023-10-06 updated particle sensor footprint and comms board footprint, minor layout updates
    [Digital_IO.kicad_sch, OSM_env01.kicad_pcb, OSM_env01.kicad_sch]
2023-10-13 minor update to layout
    [Digital_IO.kicad_sch, OSM_env01.kicad_pcb, OSM_env01.kicad_sch]
2023-10-31 added tracking to layout
    [CanTransciever.kicad_sch, Digital_IO.kicad_sch, OSM_env01.kicad_pcb, OSM_env01.kicad_sch, PowerSupply.kicad_sch, RS485_Comms.kicad_sch, Sensors_AND_IO.kicad_sch, USB_debug.kicad_sch]
2023-10-31 added further tracking to layout
    [Digital_IO.kicad_sch, OSM_env01.kicad_pcb, OSM_env01.kicad_sch]
2023-11-02 minor updates to layout
    [Digital_IO.kicad_sch, OSM_env01.kicad_pcb, OSM_env01.kicad_sch, Sensors_AND_IO.kicad_sch]
2023-11-03 updated stm32 pinmap
    [Digital_IO.kicad_sch, OSM_env01.kicad_pcb, OSM_env01.kicad_sch, PowerSupply.kicad_sch, STM32L4.kicad_sch, Sensors_AND_IO.kicad_sch]
2023-11-07 updated tracking on layout
    [Digital_IO.kicad_sch, OSM_env01.kicad_pcb, OSM_env01.kicad_sch]
2023-11-07 d sub pinmap change to suport RS485 or CAN
    [Digital_IO.kicad_sch, OSM_env01.kicad_pcb, OSM_env01.kicad_sch, Sensors_AND_IO.kicad_sch]
2023-11-08 updated layout with new postion of jumpers for hardware selection
    [OSM_env01.kicad_pcb]
2023-11-09 updated layout with updated comms board footprint and jumpers
    [Digital_IO.kicad_sch, OSM_env01.kicad_pcb, OSM_env01.kicad_sch]
2023-11-10 updated comms board footprint with comms board and sma 3d model
    [OSM_env01.kicad_pcb]
2023-11-13 started to add differential tracking on layout
    [Digital_IO.kicad_sch, OSM_env01.kicad_pcb, OSM_env01.kicad_sch]
2023-11-14 updated placement of parts
    [Digital_IO.kicad_sch, OSM_env01.kicad_pcb, OSM_env01.kicad_sch, PowerSupply.kicad_sch]
2023-11-15 Re-done tracking on layout and added rs232 pullup resistors
    [Digital_IO.kicad_sch, OSM_env01.kicad_pcb, OSM_env01.kicad_sch]
2023-11-15 updated comms board symbol and footprint, and tracked board with additional connections
    [Digital_IO.kicad_sch, OSM_env01.kicad_pcb, OSM_env01.kicad_sch]
2023-11-15 tidy tracking, added stitching vias and gnd planes
2023-11-16 got rid of most errors on the layout
    [Digital_IO.kicad_sch, OSM_env01.kicad_sch]
2023-11-16 layout updated with a few ic packages due to errors, silk screen tidy up, logos added, minor update to rs232 schematics and pinmap to stm
    [Digital_IO.kicad_sch, OSM_env01.kicad_sch, RS232_comms.kicad_sch, STM32L4.kicad_sch, Sensors_AND_IO.kicad_sch, USB_debug.kicad_sch]
2023-11-17 Finished schematics and layout
    [Digital_IO.kicad_sch, OSM_env01.kicad_pcb, OSM_env01.kicad_sch, PowerSupply.kicad_sch]
2023-11-17 added information to symbol entries table, added jumper settings table, minor single track update on layout
    [ADC_Filtering.kicad_sch, CanTransciever.kicad_sch, Digital_IO.kicad_sch, OSM_env01.kicad_pcb, OSM_env01.kicad_sch, PowerSupply.kicad_sch, RS232_comms.kicad_sch, RS485_Comms.kicad_sch]
2023-11-22 added extra gnd testpoint to schematic and minor update to layout
    [Digital_IO.kicad_sch, OSM_env01.kicad_sch]
2023-11-23 updated pulse circuit for 3.3v-24v input and started layout updates
    [OSM_env01.kicad_sch, Sensors_AND_IO.kicad_sch]
2023-11-23 updated pulse circuit, layout and symbol fields
    [ADC_Filtering.kicad_sch, CanTransciever.kicad_sch, OSM_env01.kicad_sch, PowerSupply.kicad_sch, RS232_comms.kicad_sch, RS485_Comms.kicad_sch, STM32L4.kicad_sch, Sensors_AND_IO.kicad_sch]
2023-12-05 schematic and layout changes based on first round of review comments
    [ADC_Filtering.kicad_sch, CanTransciever.kicad_sch, OSM_env01.kicad_sch, PowerSupply.kicad_sch, RS232_comms.kicad_sch, RS485_Comms.kicad_sch, STM32L4.kicad_sch, Sensors_AND_IO.kicad_sch]
2023-12-07 removed 0R links and DNF parts on schematics
    [CanTransciever.kicad_sch, OSM_env01.kicad_sch, PowerSupply.kicad_sch, RS232_comms.kicad_sch, RS485_Comms.kicad_sch, STM32L4.kicad_sch, Sensors_AND_IO.kicad_sch, USB_debug.kicad_sch]
2023-12-07 updated 1.5mm test pads footprint on the layout
    [ADC_Filtering.kicad_sch, CanTransciever.kicad_sch, OSM_env01.kicad_pcb, OSM_env01.kicad_sch, PowerSupply.kicad_sch, RS232_comms.kicad_sch, RS485_Comms.kicad_sch, STM32L4.kicad_sch]
2023-12-07 tidy up of silk text on layout
    [OSM_env01.kicad_pcb]
2023-12-07 updated layout with 3.3mm mounting holes
    [OSM_env01.kicad_pcb, OSM_env01.kicad_sch]
2023-12-08 minor update to schematic and layout, extra gnd test points, rev d gerbers added and updated manufacturing pack
    [ADC_Filtering.kicad_sch, CanTransciever.kicad_sch, OSM_env01.kicad_pcb, OSM_env01.kicad_sch, PowerSupply.kicad_sch, RS232_comms.kicad_sch, RS485_Comms.kicad_sch, STM32L4.kicad_sch]
2023-12-19 Rev D finished, minor update to bom, schematic exported and folder structure updated
    [ADC_Filtering.kicad_sch, CanTransciever.kicad_sch, OSM_ENV01_BOM_REVB.ods, OSM_ENV01_BOM_REVB_2.ods, OSM_ENV01_BOM_REVC_V1.ods, OSM_ENV01_BOM_REVC_V2.ods, OSM_ENV01_BOM_REVC_V3.1.ods, OSM_ENV01_BOM_RevA.ods]
2024-01-22 cleaned up old files
    [CanTransceiver.kicad_sch, CanTransciever.sch, DigitalIO.sch, Digital_IO.kicad_sch, Digital_IO.sch, InputConditioning.kicad_sch, LORA.kicad_sch, LORA.sch]
2024-01-22 Ignore Kicad ERC report files.
