devtank-ltd/osm_env01_kicad/(notices)

Notices in the files:
kicad_osm_env01/OSM_env01.kicad_pcb:
(c) Copyright 2023 Devtank Ltd
Licensed under CERN-OHL-W V2.0
https://cern-ohl.web.cern.ch
